briansune/LM25119_30A_EVB/thermal/IMG_20240531_173420.jpg

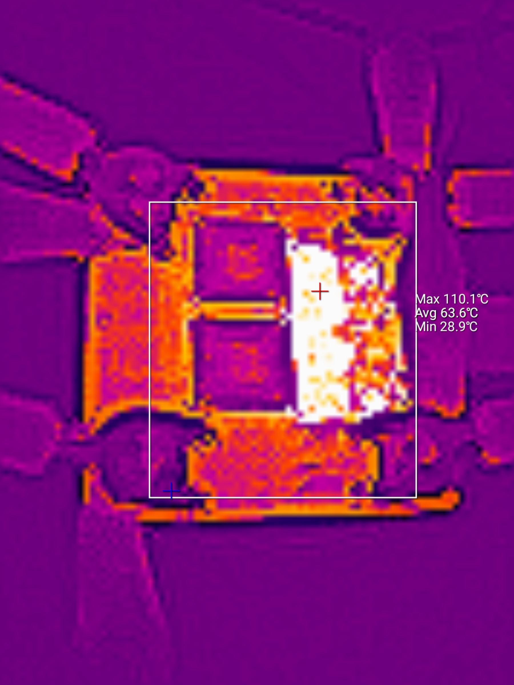
thermal/IMG_20240531_173420.jpg
