briansune/LM25119_30A_EVB/thermal/232khz.jpg

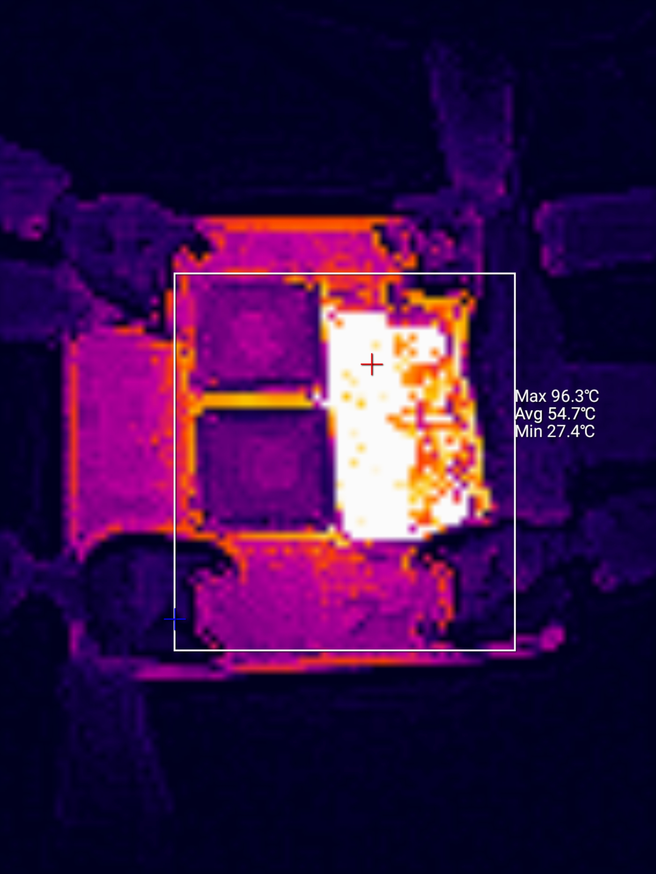
thermal/232khz.jpg
