briansune/LM25119_30A_EVB/thermal_150khz/150khz.jpg

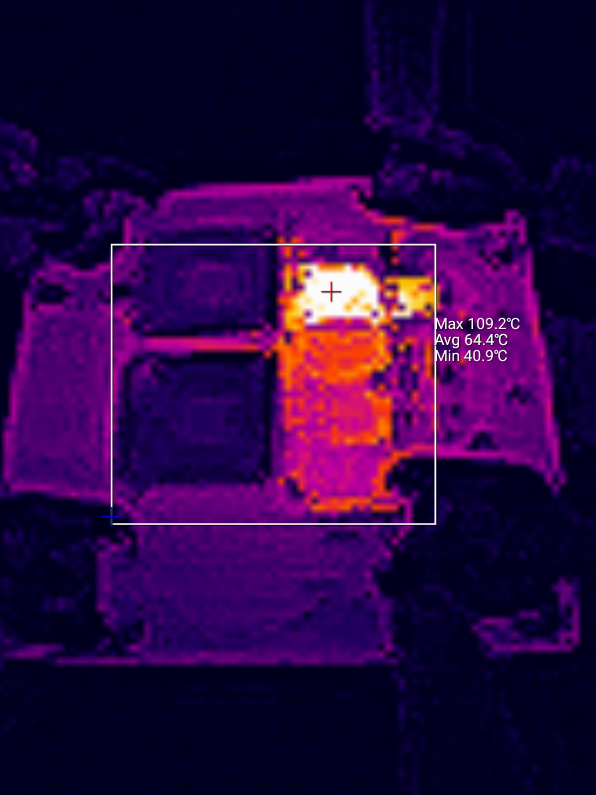
thermal_150khz/150khz.jpg
