briansune/LM25119_30A_EVB/thermal_150khz/IMG_20240606_025009.jpg

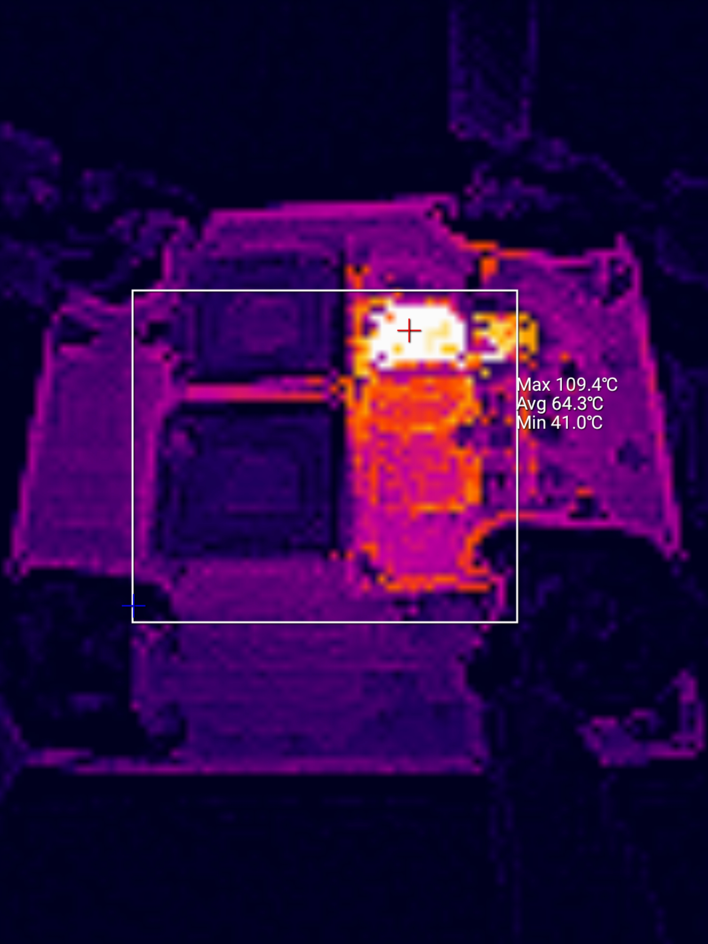
thermal_150khz/IMG_20240606_025009.jpg
