briansune/LM25119_30A_EVB/LM(2)5119 QuickStart ICC Modified.xlsx

Sheet: LM(2)5119 Calculator
LM(2)5119 Wide VIN Range Dual Synchronous Buck Controller
Note: The components calculated here are reasonable starting values for a design using the LM(2)5119 wide VIN controller. As such, components are not optimized for any particular performance attribute. Only one channel is shown. Calculate each channel separately for dual-output designs. Each channel is identical for interleaved designs.
Enter design parameters |  | Version 1.5 1/27/2014
in the shaded cells
Step 1: General Requirements | VIN (min) [V] | 24
 | VIN (max) [V] | 34
 | VOUT [V] | 3.31
 | Max Load Current per Channel [A] | 18 | 36
 | Ripple Current as % of Max Load Current | 22%
 | Minimum Duty Cycle | 0.10
 | Maximum Duty Cycle | 0.14
Step 2: Interleaved or Dual O/P | Interleaved / Dual Output Operation | Interleaved
 | IC Package | WQFN-32
 | Recommended IC | LM25119
Step 3: Switching Frequency | FSW [kHz] | 232
Step 4: Frequency Programming | Recommneded RT [kΩ] | 21.5
Step 5: Filter Inductance | Recommended LF per channel [µH] | 3.3
 | Enter LF [µH] | 3.3
 | Max Inductor Ripple Current [A] | 3.9
Step 6: Current Limit | Target (% beyond Max Load) | 20%
 | Output Current at Current Limit Inception [A] | 21.6
 | Slope Compensation Factor (K) | 2.4
 | Recommended RS [mΩ] per Channel | 4.0
 | Enter Closest Standard Value for RS [mΩ] | 4
 | Peak Output Current with Output Short [A] | 31.0
Step 7: Ramp Configuration | RRAMP [kΩ] | 82
 | Recommneded CRAMP [pF] | 419.2073171
Step 8: Output Capacitors | COUT1 per channel [µF] | 495
 | COUT2 per channel [µF]
 | Net Output Cap ESR per channel [mΩ] | 6 | 3
 | COUT1 + COUT2 [µF] | 495 | 990
 | Peak-peak VOUT Ripple [mV] | 23.8
Step 9: Input Capacitors | Input Capacitor CIN [µF] | 44
 | Input Voltage Ripple [V)] | 0.44
Step 10: VIN UV Shutdown | UV Shutdown Voltage [V] | 6.91
 | UV Hysteresis, VHYS [V] | 1.36
 | Upper UVLO Resistor RUV2 [kΩ] | 68.0
 | Lower UVLO Resistor RUV1 [kΩ] | 15.02
Step 11: Feedback Resistors | Lower FB Resistor RFB1 [kΩ] | 0.976
 | Upper FB Resistor RFB2 [kΩ] | 3.06
Step 12: Compensation Network | Loop Bandwidth [kHz] | 23
 | Recommended RCOMP [kΩ] | 13.3
 | RCOMP [kΩ] | 12
 | Recommneded CCOMP [nF] | 5.3
 | CCOMP [nF] | 5.6
 | Recommended Max CHF [pF] | 258.9444185
 | Recommended Min CHF [pF] | 24.85987175
 | CHF [pF] | 1
Step 13: Soft-Start Capacitor | Soft-Start Time [ms] | 0.1
 | Soft-Start Capacitor CSS [nF] | 1.25
Step 14: MOSFET Gate Charge | High-side MOSFET Qg @ VVCC [nC] | 28
 | Low-side MOSFET Qg @ VVCC [nC] | 28
 | MOSFET Total Gate Charge [nC] | 56
Step 15: Boot & VCC Capacitors | Minimum CVCC [µF] | 0.37
 | Minimum CHB [µF] | 0.19
 | VCC Run Current IVCC [mA] | 16.892
Step 16: Restart Capacitor | Restart Time [ms] | 59
 | Restart Capacitor CRES [µF] | 0.47

Sheet: Power Dissipation
LM(2)5119 Power Dissipation Calculations
Enter design parameters in the shaded cells
 |  | Common Assumptions |  |  |  |  |  | Channel 2 Requirements
 | Ambient Temperature TA | 35°C |  |  |  |  | High-side MOSFET Qg @ VVCC (nC) | 28
 | Package thermal Resisitance RJA | 40°C/W |  |  |  |  | Low-side MOSFET Qg @ VVCC (nC) | 28
 | External VCC Select "Yes" or "No" | No |  |  |  |  | Channel 2 Total Gate Charge (nC) | 56
 |  | 10 |  |  |  |  | Channel 2 VCC Run Current ICC (mA) | 12.992
Channel 1 Thermal Calculations
VIN | 24.0V | 25.0V | 26.0V | 22.1V | 28.0V | 29.0V | 30.0V | 31.0V | 32.0V | 33.0V | 34.0V
IC Power | 0.549W | 0.572W | 0.595W | 0.506W | 0.641W | 0.664W | 0.687W | 0.710W | 0.733W | 0.755W | 0.778W
DTJ above TA | 21.97632°C | 22.892°C | 23.80768°C | 20.236528°C | 25.63904°C | 26.55472°C | 27.4704°C | 28.38608°C | 29.30176°C | 30.21744°C | 31.13312°C
Junction Temperature | 56.97632°C | 57.892°C | 58.80768°C | 55.236528°C | 60.63904°C | 61.55472°C | 62.4704°C | 63.38608°C | 64.30176°C | 65.21744°C | 66.13312°C
Channel 2 Thermal Calculations
VIN | 24.0V | 25.0V | 26.0V | 22.1V | 28.0V | 29.0V | 30.0V | 31.0V | 32.0V | 33.0V | 34.0V
IC Power | 0.345W | 0.360W | 0.374W | 0.318W | 0.403W | 0.417W | 0.432W | 0.446W | 0.461W | 0.475W | 0.489W
DTJ above TA | 13.81632°C | 14.392°C | 14.96768°C | 12.722528°C | 16.11904°C | 16.69472°C | 17.2704°C | 17.84608°C | 18.42176°C | 18.99744°C | 19.57312°C
Junction Temperature | 48.81632°C | 49.392°C | 49.96768°C | 47.722528°C | 51.11904°C | 51.69472°C | 52.2704°C | 52.84608°C | 53.42176°C | 53.99744°C | 54.57312°C
Channel 1 + Channel 2 Thermal Calculations
VIN | 24.0V | 25.0V | 26.0V | 22.1V | 28.0V | 29.0V | 30.0V | 31.0V | 32.0V | 33.0V | 34.0V
Total IC Power | 0.895W | 0.932W | 0.969W | 0.824W | 1.044W | 1.081W | 1.119W | 1.156W | 1.193W | 1.230W | 1.268W
DTJ above TA | 35.79264°C | 37.284°C | 38.77536°C | 32.959056°C | 41.75808°C | 43.24944°C | 44.7408°C | 46.23216°C | 47.72352°C | 49.21488°C | 50.70624°C
Junction Temperature | 70.79264°C | 72.284°C | 73.77536°C | 67.959056°C | 76.75808°C | 78.24944°C | 79.7408°C | 81.23216°C | 82.72352°C | 84.21488°C | 85.70624°C

Sheet: Bode Plots
LM(2)5119 Bode Plot Calculations
Frequency (Hz) | Frequency (rad/sec) | Modulator Gain (dB) | Modulator Phase (°) | Error Amplifier Gain (dB) | Error Amplifier Phase (°) | Loop Gain (dB) | Loop Phase (°) | Frequency Compensation Parameters
1 | 6.283185307 | 10.0 | -0.02487870666 | 67.37213114 | 165.2225541 | 77.4 | 165.2 | Modulator
2 | 12.56637061 | 10.0 | -0.0497574059 | 66.59557892 | 152.1925431 | 76.6 | 152.1 | ωp_lf | 15652.42678 | rad/s | 2491.161093 | Hz
5 | 31.41592654 | 10.0 | -0.1 | 63.27902162 | 127.2413816 | 73.3 | 127.1 | ωp_hf | 122105.2632 | rad/s | 19.4 | kHz
10 | 62.83185307 | 10.0 | -0.2 | 58.64416824 | 110.9677735 | 68.6 | 110.7 | ωz_esr | 336700.3367 | rad/s | 53.6 | kHz | Additional Definitions
20 | 125.6637061 | 10.0 | -0.5 | 53.05233031 | 101.1923611 | 63.0 | 100.7 | ωp_esr | 100000000000 | rad/s | 15915494.31 | kHz
50 | 314.1592654 | 10.0 | -1.2 | 45.22313022 | 95.52146884 | 55.2 | 94.3 | ωn | 728849.4956 | rad/s | 116 | kHz | RLOAD | 0.1838888889 | Ω
100 | 628.3185307 | 10.0 | -2.5 | 39.22692357 | 94.55226057 | 49.2 | 92.1 |  |  |  |  |  | DC GAIN MOD | 0.005 | V/V
200 | 1256.637061 | 10.0 | -5.0 | 33.23410489 | 95.84534419 | 43.2 | 90.9 | Am | 3.2 | V/V | 10.0 | dB | VCC | 7.6 | V
400 | 2513.274123 | 9.9 | -9.9 | 27.30594019 | 99.99710187 | 37.2 | 90.1
600 | 3769.911184 | 9.7 | -14.7 | 23.9323076 | 104.380536 | 33.7 | 89.7
800 | 5026.548246 | 9.6 | -19.3 | 21.63265121 | 108.6725798 | 31.2 | 89.4
1000 | 6283.185307 | 9.3 | -23.7 | 19.93767901 | 112.7795052 | 29.3 | 89.0 | Error Amplifier
1200 | 7539.822369 | 9.1 | -28.0 | 18.63391943 | 116.6570249 | 27.7 | 88.7 | ωzero | 14880.95238 | rad/s | 2368.377129 | Hz
1500 | 9424.777961 | 8.6 | -33.9 | 17.16800386 | 122.0000945 | 25.8 | 88.1 | ωpole | 58304.33888 | rad/s | 9.3 | kHz
2000 | 12566.37061 | 7.8 | -42.5 | 15.54208004 | 129.6316731 | 23.3 | 87.1 | ωhf | 83348214.29 | rad/s | 13265.3 | kHz
3000 | 18849.55592 | 6.0 | -55.9 | 13.83894238 | 140.7979323 | 19.8 | 84.9 | ωbw | 18849555.92 | rad/s | 3 | MHz
4000 | 25132.74123 | 4.3 | -65.5 | 13.03929624 | 148.1118435 | 17.3 | 82.7
5000 | 31415.92654 | 2.7 | -72.6 | 12.61194946 | 153.0567225 | 15.4 | 80.4
6000 | 37699.11184 | 1.3 | -78.3 | 12.36013458 | 156.5267067 | 13.7 | 78.3 | AOL | 10000 | V/V | 80 | dB
7000 | 43982.29715 | 0.1 | -82.8 | 12.2001156 | 159.0416324 | 12.3 | 76.2 | ωol | 1884.955592 | rad/s | 300 | Hz
8000 | 50265.48246 | -1.1 | -86.7 | 12.09215388 | 160.9115758 | 11.0 | 74.2 | AEA | -1.57 | V/V |  |  |  | q
9000 | 56548.66776 | -2.2 | -90.0 | 12.01566328 | 162.3290103 | 9.8 | 72.4 | ZEA | 9279.424563 | Ω |  |  |  | 0.167531519
10000 | 62831.85307 | -3.2 | -92.8 | 11.95919427 | 163.4183121 | 8.8 | 70.6 | ωo | 58304.33888 | rad/s | 9.3 | kHz |  | Fcross Max (kHz)
12000 | 75398.22369 | -5.0 | -97.6 | 11.88189678 | 164.9203803 | 6.9 | 67.3 |  |  |  |  |  |  | 18.91684046
15000 | 94247.77961 | -7.3 | -103.1 | 11.81141944 | 166.1300517 | 4.5 | 63.1 | Zea | 3.967 | Ω |  |  |  | Correction Factor
20000 | 125663.7061 | -10.6 | -109.1 | 11.74029902 | 166.7205274 | 1.1 | 57.6 | KFB | 0.242 | V/V | -12.3 | dB |  | 1.52
30000 | 188495.5592 | -15.6 | -114.9 | 11.63711617 | 165.7404386 | -4.0 | 50.9
40000 | 251327.4123 | -19.2 | -116.5 | 11.52960976 | 163.7087027 | -7.7 | 47.2
60000 | 376991.1184 | -24.2 | -116.0 | 11.25876319 | 158.7707224 | -12.9 | 42.7
100000 | 628318.5307 | -29.8 | -113.9 | 10.50764358 | 148.8295696 | -19.3 | 34.9
200000 | 1256637.061 | -36.8 | -115.1 | 8.098957948 | 130.4058521 | -28.7 | 15.3
350000 | 2199114.858 | -42.5 | -122.5 | 4.733870447 | 116.0483491 | -37.7 | -6.5
600000 | 3769911.184 | -48.7 | -134.7 | 0.6646070699 | 105.8568764 | -48.1 | -28.8
1000000 | 6283185.307 | -55.7 | -147.9 | -3.549684547 | 99.5246886 | -59.2 | -48.3
