briansune/LM25119_30A_EVB/LM(2)5119 QuickStart ICC Modified_2u2H.xlsx

Sheet: LM(2)5119 Calculator
LM(2)5119 Wide VIN Range Dual Synchronous Buck Controller
Note: The components calculated here are reasonable starting values for a design using the LM(2)5119 wide VIN controller. As such, components are not optimized for any particular performance attribute. Only one channel is shown. Calculate each channel separately for dual-output designs. Each channel is identical for interleaved designs.
Enter design parameters |  | Version 1.5 1/27/2014
in the shaded cells
Step 1: General Requirements | VIN (min) [V] | 24
 | VIN (max) [V] | 34
 | VOUT [V] | 3.31
 | Max Load Current per Channel [A] | 18 | 36
 | Ripple Current as % of Max Load Current | 40%
 | Minimum Duty Cycle | 0.10
 | Maximum Duty Cycle | 0.14
Step 2: Interleaved or Dual O/P | Interleaved / Dual Output Operation | Interleaved
 | IC Package | WQFN-32
 | Recommended IC | LM25119
Step 3: Switching Frequency | FSW [kHz] | 126
Step 4: Frequency Programming | Recommneded RT [kΩ] | 40.3
Step 5: Filter Inductance | Recommended LF per channel [µH] | 3.3
 | Enter LF [µH] | 3.3
 | Max Inductor Ripple Current [A] | 7.2
Step 6: Current Limit | Target (% beyond Max Load) | 20%
 | Output Current at Current Limit Inception [A] | 21.6
 | Slope Compensation Factor (K) | 1.5
 | Recommended RS [mΩ] per Channel | 4.0
 | Enter Closest Standard Value for RS [mΩ] | 4
 | Peak Output Current with Output Short [A] | 31.0
Step 7: Ramp Configuration | RRAMP [kΩ] | 82
 | Recommneded CRAMP [pF] | 670.7317073
Step 8: Output Capacitors | COUT1 per channel [µF] | 300
 | COUT2 per channel [µF]
 | Net Output Cap ESR per channel [mΩ] | 8.333333333 | 4.166666667
 | COUT1 + COUT2 [µF] | 300 | 600
 | Peak-peak VOUT Ripple [mV] | 64.4
Step 9: Input Capacitors | Input Capacitor CIN [µF] | 44
 | Input Voltage Ripple [V)] | 0.81
Step 10: VIN UV Shutdown | UV Shutdown Voltage [V] | 6.91
 | UV Hysteresis, VHYS [V] | 1.36
 | Upper UVLO Resistor RUV2 [kΩ] | 68.0
 | Lower UVLO Resistor RUV1 [kΩ] | 15.02
Step 11: Feedback Resistors | Lower FB Resistor RFB1 [kΩ] | 0.976
 | Upper FB Resistor RFB2 [kΩ] | 3.06
Step 12: Compensation Network | Loop Bandwidth [kHz] | 23
 | Recommended RCOMP [kΩ] | 7.6
 | RCOMP [kΩ] | 6.2
 | Recommneded CCOMP [nF] | 6.4
 | CCOMP [nF] | 6.8
 | Recommended Max CHF [pF] | 428.6434695
 | Recommended Min CHF [pF] | 40.56311143
 | CHF [pF] | 1
Step 13: Soft-Start Capacitor | Soft-Start Time [ms] | 0.1
 | Soft-Start Capacitor CSS [nF] | 1.25
Step 14: MOSFET Gate Charge | High-side MOSFET Qg @ VVCC [nC] | 28
 | Low-side MOSFET Qg @ VVCC [nC] | 28
 | MOSFET Total Gate Charge [nC] | 56
Step 15: Boot & VCC Capacitors | Minimum CVCC [µF] | 0.37
 | Minimum CHB [µF] | 0.19
 | VCC Run Current IVCC [mA] | 10.956
Step 16: Restart Capacitor | Restart Time [ms] | 59
 | Restart Capacitor CRES [µF] | 0.47

Sheet: Power Dissipation
LM(2)5119 Power Dissipation Calculations
Enter design parameters in the shaded cells
 |  | Common Assumptions |  |  |  |  |  | Channel 2 Requirements
 | Ambient Temperature TA | 35°C |  |  |  |  | High-side MOSFET Qg @ VVCC (nC) | 28
 | Package thermal Resisitance RJA | 40°C/W |  |  |  |  | Low-side MOSFET Qg @ VVCC (nC) | 28
 | External VCC Select "Yes" or "No" | No |  |  |  |  | Channel 2 Total Gate Charge (nC) | 56
 |  | 10 |  |  |  |  | Channel 2 VCC Run Current ICC (mA) | 7.056
Channel 1 Thermal Calculations
VIN | 24.0V | 25.0V | 26.0V | 22.1V | 28.0V | 29.0V | 30.0V | 31.0V | 32.0V | 33.0V | 34.0V
IC Power | 0.407W | 0.424W | 0.441W | 0.375W | 0.475W | 0.492W | 0.509W | 0.526W | 0.543W | 0.560W | 0.577W
DTJ above TA | 16.27776°C | 16.956°C | 17.63424°C | 14.989104°C | 18.99072°C | 19.66896°C | 20.3472°C | 21.02544°C | 21.70368°C | 22.38192°C | 23.06016°C
Junction Temperature | 51.27776°C | 51.956°C | 52.63424°C | 49.989104°C | 53.99072°C | 54.66896°C | 55.3472°C | 56.02544°C | 56.70368°C | 57.38192°C | 58.06016°C
Channel 2 Thermal Calculations
VIN | 24.0V | 25.0V | 26.0V | 22.1V | 28.0V | 29.0V | 30.0V | 31.0V | 32.0V | 33.0V | 34.0V
IC Power | 0.203W | 0.211W | 0.220W | 0.187W | 0.237W | 0.245W | 0.254W | 0.262W | 0.271W | 0.279W | 0.288W
DTJ above TA | 8.11776°C | 8.456°C | 8.79424°C | 7.475104°C | 9.47072°C | 9.80896°C | 10.1472°C | 10.48544°C | 10.82368°C | 11.16192°C | 11.50016°C
Junction Temperature | 43.11776°C | 43.456°C | 43.79424°C | 42.475104°C | 44.47072°C | 44.80896°C | 45.1472°C | 45.48544°C | 45.82368°C | 46.16192°C | 46.50016°C
Channel 1 + Channel 2 Thermal Calculations
VIN | 24.0V | 25.0V | 26.0V | 22.1V | 28.0V | 29.0V | 30.0V | 31.0V | 32.0V | 33.0V | 34.0V
Total IC Power | 0.610W | 0.635W | 0.661W | 0.562W | 0.712W | 0.737W | 0.762W | 0.788W | 0.813W | 0.839W | 0.864W
DTJ above TA | 24.39552°C | 25.412°C | 26.42848°C | 22.464208°C | 28.46144°C | 29.47792°C | 30.4944°C | 31.51088°C | 32.52736°C | 33.54384°C | 34.56032°C
Junction Temperature | 59.39552°C | 60.412°C | 61.42848°C | 57.464208°C | 63.46144°C | 64.47792°C | 65.4944°C | 66.51088°C | 67.52736°C | 68.54384°C | 69.56032°C

Sheet: Bode Plots
LM(2)5119 Bode Plot Calculations
Frequency (Hz) | Frequency (rad/sec) | Modulator Gain (dB) | Modulator Phase (°) | Error Amplifier Gain (dB) | Error Amplifier Phase (°) | Loop Gain (dB) | Loop Phase (°) | Frequency Compensation Parameters
1 | 6.283185307 | 10.1 | -0.01615400885 | 67.24212647 | 162.2760655 | 77.3 | 162.3 | Modulator
2 | 12.56637061 | 10.1 | -0.03230801595 | 66.17515297 | 147.4197305 | 76.2 | 147.4 | ωp_lf | 25357.71515 | rad/s | 4035.805711 | Hz
5 | 31.41592654 | 10.1 | -0.1 | 62.15290281 | 122.0892623 | 72.2 | 122.0 | ωp_hf | 126000 | rad/s | 20.1 | kHz
10 | 62.83185307 | 10.1 | -0.2 | 57.16033797 | 107.5096379 | 67.2 | 107.3 | ωz_esr | 400000 | rad/s | 63.7 | kHz | Additional Definitions
20 | 125.6637061 | 10.1 | -0.3 | 51.43993301 | 99.18363983 | 61.5 | 98.9 | ωp_esr | 100000000000 | rad/s | 15915494.31 | kHz
50 | 314.1592654 | 10.1 | -0.8 | 43.56965619 | 94.32743905 | 53.6 | 93.5 | ωn | 395840.6744 | rad/s | 63 | kHz | RLOAD | 0.1838888889 | Ω
100 | 628.3185307 | 10.1 | -1.6 | 37.56404182 | 93.29000883 | 47.6 | 91.7 |  |  |  |  |  | DC GAIN MOD | 0.005 | V/V
200 | 1256.637061 | 10.1 | -3.2 | 31.55574828 | 93.89231868 | 41.6 | 90.7 | Am | 3.2 | V/V | 10.1 | dB | VCC | 7.6 | V
400 | 2513.274123 | 10.0 | -6.4 | 25.57225444 | 96.4245425 | 35.6 | 90.0
600 | 3769.911184 | 10.0 | -9.6 | 22.11042721 | 99.22198917 | 32.1 | 89.6
800 | 5026.548246 | 9.9 | -12.8 | 19.69413257 | 102.0455535 | 29.6 | 89.3
1000 | 6283.185307 | 9.8 | -15.9 | 17.85968691 | 104.8366926 | 27.7 | 89.0 | Error Amplifier
1200 | 7539.822369 | 9.7 | -18.9 | 16.39958097 | 107.5685311 | 26.1 | 88.7 | ωzero | 23719.16509 | rad/s | 3775.022369 | Hz
1500 | 9424.777961 | 9.5 | -23.3 | 14.6799562 | 111.5208758 | 24.2 | 88.2 | ωpole | 48016.85076 | rad/s | 7.6 | kHz
2000 | 12566.37061 | 9.1 | -30.3 | 12.61888474 | 117.6456353 | 21.7 | 87.4 | ωhf | 161314041.7 | rad/s | 25673.9 | kHz
3000 | 18849.55592 | 8.1 | -42.5 | 10.14841377 | 127.9960599 | 18.2 | 85.5 | ωbw | 18849555.92 | rad/s | 3 | MHz
4000 | 25132.74123 | 7.0 | -52.5 | 8.792334296 | 135.9852873 | 15.8 | 83.5
5000 | 31415.92654 | 5.8 | -60.7 | 7.984870225 | 142.0867111 | 13.8 | 81.4
6000 | 37699.11184 | 4.7 | -67.5 | 7.473724471 | 146.7776307 | 12.2 | 79.3 | AOL | 10000 | V/V | 80 | dB
7000 | 43982.29715 | 3.7 | -73.2 | 7.13346866 | 150.4335917 | 10.8 | 77.2 | ωol | 1884.955592 | rad/s | 300 | Hz
8000 | 50265.48246 | 2.7 | -78.1 | 6.897222108 | 153.3271571 | 9.6 | 75.2 | AEA | -1.57 | V/V |  |  |  | q
9000 | 56548.66776 | 1.7 | -82.4 | 6.727250161 | 155.6516731 | 8.5 | 73.2 | ZEA | 7642.119419 | Ω |  |  |  | 0.3183098862
10000 | 62831.85307 | 0.9 | -86.2 | 6.601201937 | 157.5444271 | 7.5 | 71.4 | ωo | 48016.85076 | rad/s | 7.6 | kHz |  | Fcross Max (kHz)
12000 | 75398.22369 | -0.8 | -92.6 | 6.430580826 | 160.4022092 | 5.6 | 67.8 |  |  |  |  |  |  | 18.35187243
15000 | 94247.77961 | -3.0 | -100.1 | 6.284027994 | 163.1990913 | 3.3 | 63.1 | Zea | 2.088 | Ω |  |  |  | Correction Factor
20000 | 125663.7061 | -6.2 | -109.1 | 6.161956923 | 165.7398509 | 0.003888323343 | 56.6 | KFB | 0.242 | V/V | -12.3 | dB |  | 1.44
30000 | 188495.5592 | -11.1 | -119.8 | 6.057089366 | 167.4722516 | -5.0 | 47.7
40000 | 251327.4123 | -14.8 | -125.4 | 5.998054478 | 167.4803268 | -8.8 | 42.0
60000 | 376991.1184 | -20.2 | -131.1 | 5.894014057 | 165.7714753 | -14.3 | 34.7
100000 | 628318.5307 | -26.8 | -137.1 | 5.628546627 | 160.4661043 | -21.1 | 23.3
200000 | 1256637.061 | -36.1 | -148.8 | 4.596856283 | 146.8730637 | -31.5 | -1.9
350000 | 2199114.858 | -44.5 | -159.3 | 2.611544749 | 131.7430082 | -41.9 | -27.6
600000 | 3769911.184 | -53.4 | -167.2 | -0.5186188702 | 117.5765757 | -53.9 | -49.7
1000000 | 6283185.307 | -62.0 | -172.2 | -4.291730772 | 107.2970142 | -66.3 | -64.9
