briansune/LM25119_30A_EVB/LM(2)5119 QuickStart ICC Modified_3u3H.xlsx

Sheet: LM(2)5119 Calculator
LM(2)5119 Wide VIN Range Dual Synchronous Buck Controller
Note: The components calculated here are reasonable starting values for a design using the LM(2)5119 wide VIN controller. As such, components are not optimized for any particular performance attribute. Only one channel is shown. Calculate each channel separately for dual-output designs. Each channel is identical for interleaved designs.
Enter design parameters |  | Version 1.5 1/27/2014
in the shaded cells
Step 1: General Requirements | VIN (min) [V] | 24
 | VIN (max) [V] | 34
 | VOUT [V] | 3.31
 | Max Load Current per Channel [A] | 18 | 36
 | Ripple Current as % of Max Load Current | 33%
 | Minimum Duty Cycle | 0.10
 | Maximum Duty Cycle | 0.14
Step 2: Interleaved or Dual O/P | Interleaved / Dual Output Operation | Interleaved
 | IC Package | WQFN-32
 | Recommended IC | LM25119
Step 3: Switching Frequency | FSW [kHz] | 152.5
Step 4: Frequency Programming | Recommneded RT [kΩ] | 33.2
Step 5: Filter Inductance | Recommended LF per channel [µH] | 3.3
 | Enter LF [µH] | 3.3
 | Max Inductor Ripple Current [A] | 5.9
Step 6: Current Limit | Target (% beyond Max Load) | 20%
 | Output Current at Current Limit Inception [A] | 21.6
 | Slope Compensation Factor (K) | 1.7
 | Recommended RS [mΩ] per Channel | 4.0
 | Enter Closest Standard Value for RS [mΩ] | 4
 | Peak Output Current with Output Short [A] | 31.0
Step 7: Ramp Configuration | RRAMP [kΩ] | 75
 | Recommneded CRAMP [pF] | 647.0588235
Step 8: Output Capacitors | COUT1 per channel [µF] | 660
 | COUT2 per channel [µF]
 | Net Output Cap ESR per channel [mΩ] | 4.5 | 2.25
 | COUT1 + COUT2 [µF] | 660 | 1320
 | Peak-peak VOUT Ripple [mV] | 27.7
Step 9: Input Capacitors | Input Capacitor CIN [µF] | 188
 | Input Voltage Ripple [V)] | 0.16
Step 10: VIN UV Shutdown | UV Shutdown Voltage [V] | 15.35
 | UV Hysteresis, VHYS [V] | 2
 | Upper UVLO Resistor RUV2 [kΩ] | 100.0
 | Lower UVLO Resistor RUV1 [kΩ] | 8.87
Step 11: Feedback Resistors | Lower FB Resistor RFB1 [kΩ] | 0.976
 | Upper FB Resistor RFB2 [kΩ] | 3.06
Step 12: Compensation Network | Loop Bandwidth [kHz] | 14.9
 | Recommended RCOMP [kΩ] | 9.2
 | RCOMP [kΩ] | 10
 | Recommneded CCOMP [nF] | 8.6
 | CCOMP [nF] | 8.2
 | Recommended Max CHF [pF] | 308.1614577
 | Recommended Min CHF [pF] | 29.80796299
 | CHF [pF] | 1
Step 13: Soft-Start Capacitor | Soft-Start Time [ms] | 0.8
 | Soft-Start Capacitor CSS [nF] | 10
Step 14: MOSFET Gate Charge | High-side MOSFET Qg @ VVCC [nC] | 28
 | Low-side MOSFET Qg @ VVCC [nC] | 28
 | MOSFET Total Gate Charge [nC] | 56
Step 15: Boot & VCC Capacitors | Minimum CVCC [µF] | 0.37
 | Minimum CHB [µF] | 0.19
 | VCC Run Current IVCC [mA] | 12.44
Step 16: Restart Capacitor | Restart Time [ms] | 59
 | Restart Capacitor CRES [µF] | 0.47

Sheet: Power Dissipation
LM(2)5119 Power Dissipation Calculations
Enter design parameters in the shaded cells
 |  | Common Assumptions |  |  |  |  |  | Channel 2 Requirements
 | Ambient Temperature TA | 35°C |  |  |  |  | High-side MOSFET Qg @ VVCC (nC) | 28
 | Package thermal Resisitance RJA | 40°C/W |  |  |  |  | Low-side MOSFET Qg @ VVCC (nC) | 28
 | External VCC Select "Yes" or "No" | No |  |  |  |  | Channel 2 Total Gate Charge (nC) | 56
 |  | 10 |  |  |  |  | Channel 2 VCC Run Current ICC (mA) | 8.54
Channel 1 Thermal Calculations
VIN | 24.0V | 25.0V | 26.0V | 22.1V | 28.0V | 29.0V | 30.0V | 31.0V | 32.0V | 33.0V | 34.0V
IC Power | 0.443W | 0.461W | 0.479W | 0.408W | 0.516W | 0.535W | 0.553W | 0.572W | 0.590W | 0.609W | 0.627W
DTJ above TA | 17.7024°C | 18.44°C | 19.1776°C | 16.30096°C | 20.6528°C | 21.3904°C | 22.128°C | 22.8656°C | 23.6032°C | 24.3408°C | 25.0784°C
Junction Temperature | 52.7024°C | 53.44°C | 54.1776°C | 51.30096°C | 55.6528°C | 56.3904°C | 57.128°C | 57.8656°C | 58.6032°C | 59.3408°C | 60.0784°C
Channel 2 Thermal Calculations
VIN | 24.0V | 25.0V | 26.0V | 22.1V | 28.0V | 29.0V | 30.0V | 31.0V | 32.0V | 33.0V | 34.0V
IC Power | 0.239W | 0.249W | 0.258W | 0.220W | 0.278W | 0.288W | 0.298W | 0.308W | 0.318W | 0.328W | 0.338W
DTJ above TA | 9.5424°C | 9.94°C | 10.3376°C | 8.78696°C | 11.1328°C | 11.5304°C | 11.928°C | 12.3256°C | 12.7232°C | 13.1208°C | 13.5184°C
Junction Temperature | 44.5424°C | 44.94°C | 45.3376°C | 43.78696°C | 46.1328°C | 46.5304°C | 46.928°C | 47.3256°C | 47.7232°C | 48.1208°C | 48.5184°C
Channel 1 + Channel 2 Thermal Calculations
VIN | 24.0V | 25.0V | 26.0V | 22.1V | 28.0V | 29.0V | 30.0V | 31.0V | 32.0V | 33.0V | 34.0V
Total IC Power | 0.681W | 0.710W | 0.738W | 0.627W | 0.795W | 0.823W | 0.851W | 0.880W | 0.908W | 0.937W | 0.965W
DTJ above TA | 27.2448°C | 28.38°C | 29.5152°C | 25.08792°C | 31.7856°C | 32.9208°C | 34.056°C | 35.1912°C | 36.3264°C | 37.4616°C | 38.5968°C
Junction Temperature | 62.2448°C | 63.38°C | 64.5152°C | 60.08792°C | 66.7856°C | 67.9208°C | 69.056°C | 70.1912°C | 71.3264°C | 72.4616°C | 73.5968°C

Sheet: Bode Plots
LM(2)5119 Bode Plot Calculations
Frequency (Hz) | Frequency (rad/sec) | Modulator Gain (dB) | Modulator Phase (°) | Error Amplifier Gain (dB) | Error Amplifier Phase (°) | Loop Gain (dB) | Loop Phase (°) | Frequency Compensation Parameters
1 | 6.283185307 | 10.1 | -0.03265013504 | 67.0642484 | 158.9601593 | 77.2 | 158.9 | Modulator
2 | 12.56637061 | 10.1 | -0.1 | 65.64127608 | 142.4443719 | 75.7 | 142.4 | ωp_lf | 11655.55974 | rad/s | 1855.039947 | Hz
5 | 31.41592654 | 10.1 | -0.2 | 60.93468917 | 117.5821135 | 71.0 | 117.4 | ωp_hf | 127083.3333 | rad/s | 20.2 | kHz
10 | 62.83185307 | 10.1 | -0.3 | 55.66736276 | 104.8437167 | 65.8 | 104.5 | ωz_esr | 336700.3367 | rad/s | 53.6 | kHz | Additional Definitions
20 | 125.6637061 | 10.1 | -0.7 | 49.85774613 | 97.97970407 | 59.9 | 97.3 | ωp_esr | 100000000000 | rad/s | 15915494.31 | kHz
50 | 314.1592654 | 10.1 | -1.6 | 41.96222235 | 94.43359885 | 52.1 | 92.8 | ωn | 479092.8797 | rad/s | 76.25 | kHz | RLOAD | 0.1838888889 | Ω
100 | 628.3185307 | 10.1 | -3.3 | 35.95901753 | 94.40851304 | 46.0 | 91.1 |  |  |  |  |  | DC GAIN MOD | 0.005 | V/V
200 | 1256.637061 | 10.0 | -6.5 | 29.97496587 | 96.57123792 | 40.0 | 90.1 | Am | 3.2 | V/V | 10.1 | dB | VCC | 7.6 | V
400 | 2513.274123 | 9.9 | -12.9 | 24.08967745 | 101.9056134 | 34.0 | 89.0
600 | 3769.911184 | 9.7 | -19.0 | 20.78366127 | 107.2592292 | 30.4 | 88.3
800 | 5026.548246 | 9.3 | -24.7 | 18.56996954 | 112.3639223 | 27.9 | 87.6
1000 | 6283.185307 | 9.0 | -30.1 | 16.97275911 | 117.1293199 | 25.9 | 87.0 | Error Amplifier
1200 | 7539.822369 | 8.6 | -35.0 | 15.77251121 | 121.517542 | 24.3 | 86.5 | ωzero | 12195.12195 | rad/s | 1940.91394 | Hz
1500 | 9424.777961 | 7.9 | -41.6 | 14.4621435 | 127.3803123 | 22.4 | 85.8 | ωpole | 39819.85149 | rad/s | 6.3 | kHz
2000 | 12566.37061 | 6.7 | -50.7 | 13.07190505 | 135.3775706 | 19.8 | 84.7 | ωhf | 100012195.1 | rad/s | 15917.4 | kHz
3000 | 18849.55592 | 4.4 | -63.5 | 11.70789747 | 146.314256 | 16.2 | 82.8 | ωbw | 18849555.92 | rad/s | 3 | MHz
4000 | 25132.74123 | 2.5 | -72.1 | 11.10691184 | 153.0417791 | 13.6 | 81.0
5000 | 31415.92654 | 0.7 | -78.3 | 10.79732287 | 157.425213 | 11.5 | 79.2
6000 | 37699.11184 | -0.8 | -83.1 | 10.61885375 | 160.4322684 | 9.9 | 77.4 | AOL | 10000 | V/V | 80 | dB
7000 | 43982.29715 | -2.1 | -87.0 | 10.50698553 | 162.5794838 | 8.4 | 75.6 | ωol | 1884.955592 | rad/s | 300 | Hz
8000 | 50265.48246 | -3.3 | -90.3 | 10.43217494 | 164.1593088 | 7.1 | 73.9 | AEA | -1.57 | V/V |  |  |  | q
9000 | 56548.66776 | -4.4 | -93.1 | 10.37947751 | 165.3472395 | 6.0 | 72.2 | ZEA | 6337.527039 | Ω |  |  |  | 0.2652582385
10000 | 62831.85307 | -5.4 | -95.6 | 10.34071734 | 166.254098 | 5.0 | 70.6 | ωo | 39819.85149 | rad/s | 6.3 | kHz |  | Fcross Max (kHz)
12000 | 75398.22369 | -7.2 | -99.9 | 10.2877983 | 167.4938512 | 3.1 | 67.6 |  |  |  |  |  |  | 18.97358465
15000 | 94247.77961 | -9.5 | -105.0 | 10.23953099 | 168.4761017 | 0.8 | 63.5 | Zea | 3.292 | Ω |  |  |  | Correction Factor
20000 | 125663.7061 | -12.7 | -111.0 | 10.19041292 | 168.9239803 | -2.5 | 58.0 | KFB | 0.242 | V/V | -12.3 | dB |  | 1.21
30000 | 188495.5592 | -17.6 | -117.5 | 10.1176192 | 168.0244983 | -7.4 | 50.5
40000 | 251327.4123 | -21.1 | -120.5 | 10.04033982 | 166.2461885 | -11.1 | 45.8
60000 | 376991.1184 | -26.1 | -122.7 | 9.842412021 | 161.9232628 | -16.3 | 39.2
100000 | 628318.5307 | -32.0 | -125.4 | 9.275907393 | 153.0111018 | -22.7 | 27.6
200000 | 1256637.061 | -40.0 | -135.2 | 7.314315842 | 135.2929065 | -32.7 | 0.1
350000 | 2199114.858 | -47.5 | -147.6 | 4.305996178 | 120.1209702 | -43.2 | -27.5
600000 | 3769911.184 | -55.7 | -159.0 | 0.4344052332 | 108.6479642 | -55.3 | -50.3
1000000 | 6283185.307 | -64.1 | -166.8 | -3.69820681 | 101.3039274 | -67.8 | -65.5
