briansune/LM25119_30A_EVB/DEBUG/LM25119_DEBUG.docx

VIN=26V

VOUT=1.7894V

VRT = 1.2411V (no wave)

VRES = 0.0004V (no wave)

VCC2=7.439V

VCC1=7.511V

Cont’d Waveforms

CH1 SW

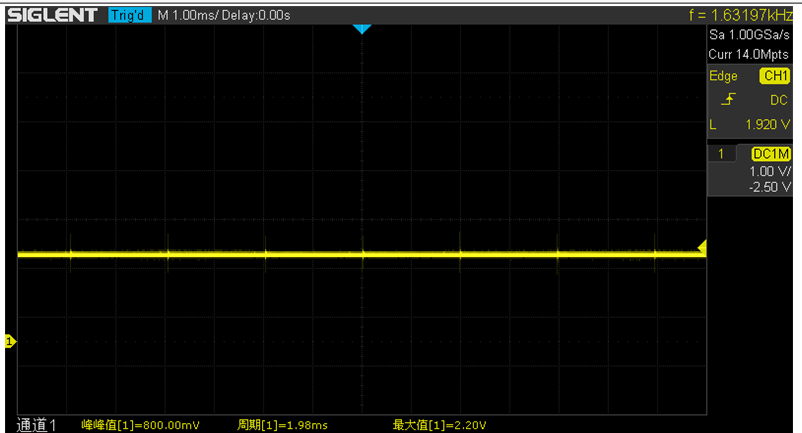
[picture p8: figure]

CH2 SW

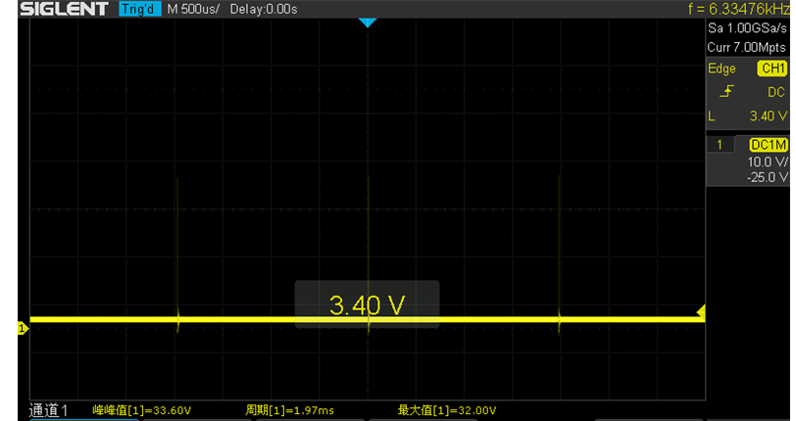
[picture p9: figure]

CH2+COMP1&2

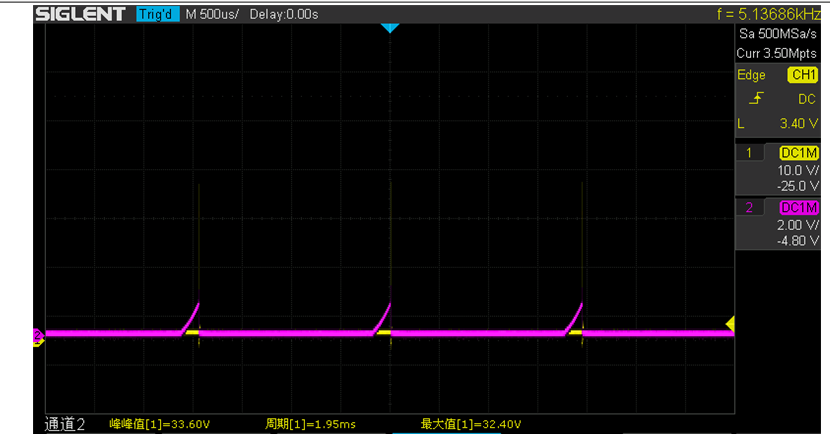
[picture p10: figure]

CH2 GATE H, GATE L

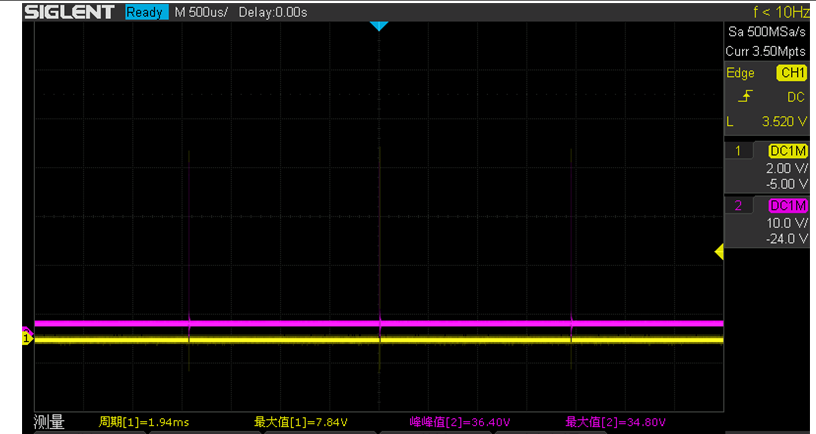
[picture p11: figure]

CH2 GATE H, GATE L

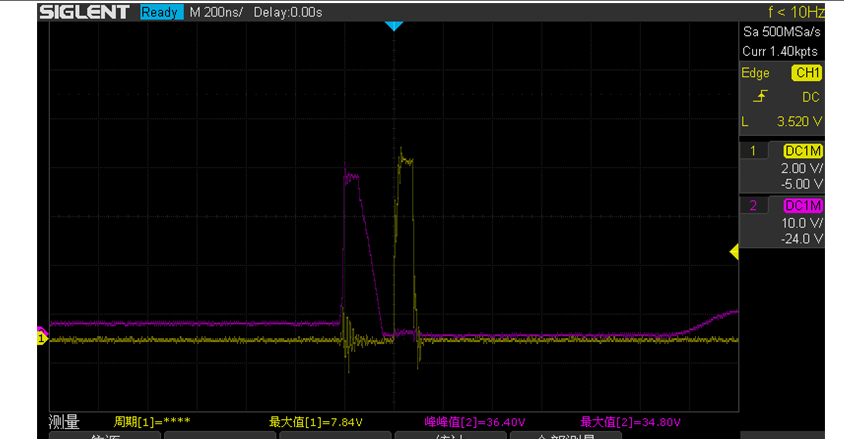
[picture p12: figure]
