briansune/LM25119_30A_EVB/DEBUG/LM25119_DEBUG3.docx

VIN=26V, VOUT=3.3V @ No LOAD

CH1 SW

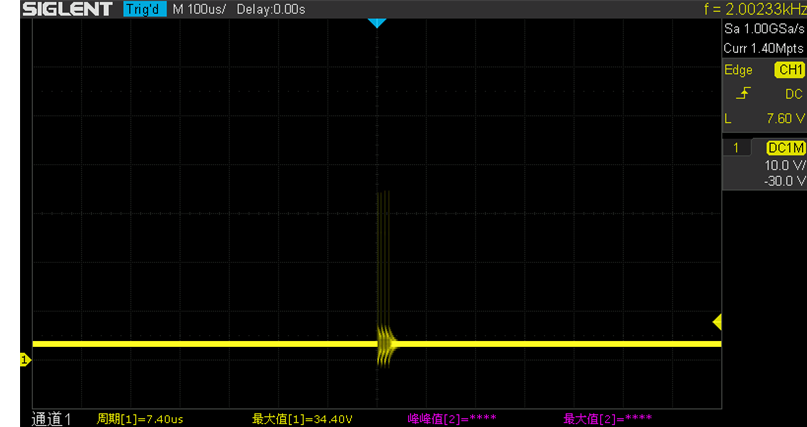
[picture p13: figure]
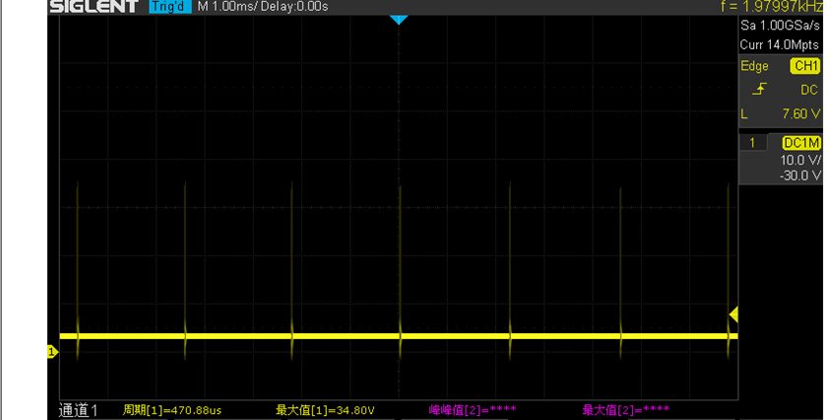
[picture p14: figure]

CH 1 GATE H

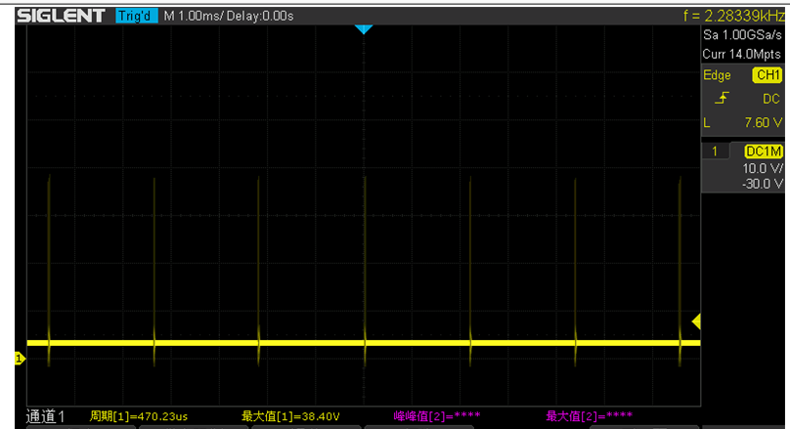
[picture p15: figure]

CH1 GATE L

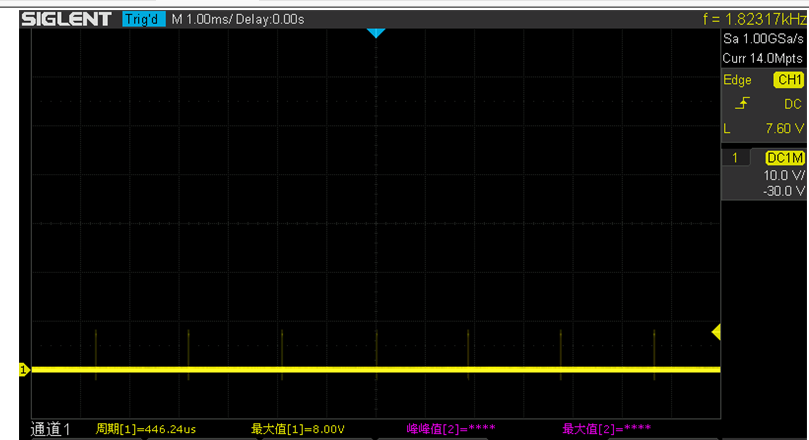
[picture p16: figure]

CH2 SW

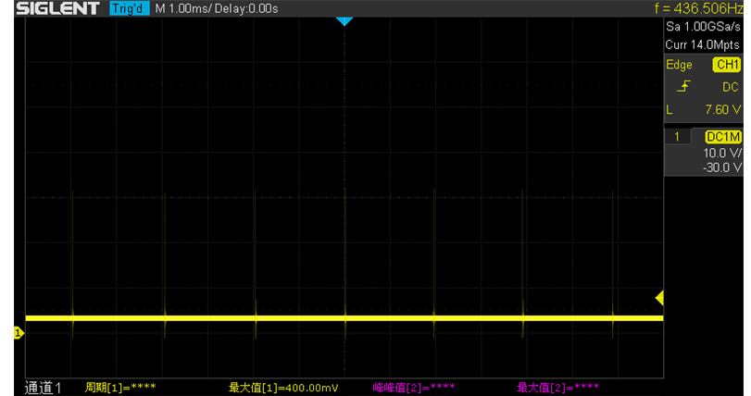
[picture p17: figure]

CH2 GATE H

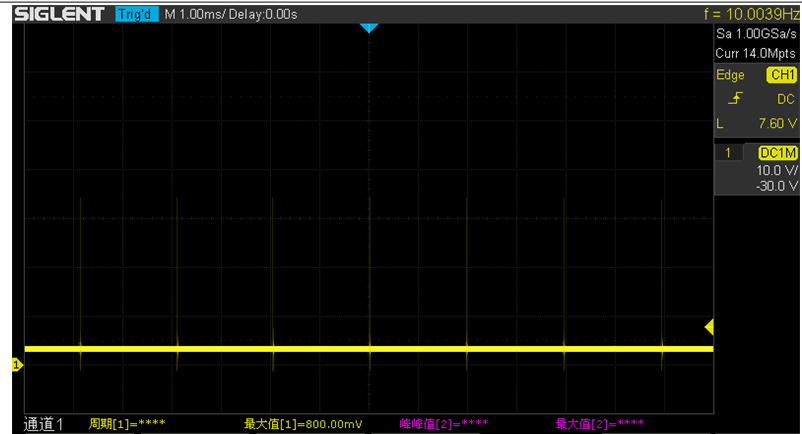
[picture p18: figure]

CH2 GATE L

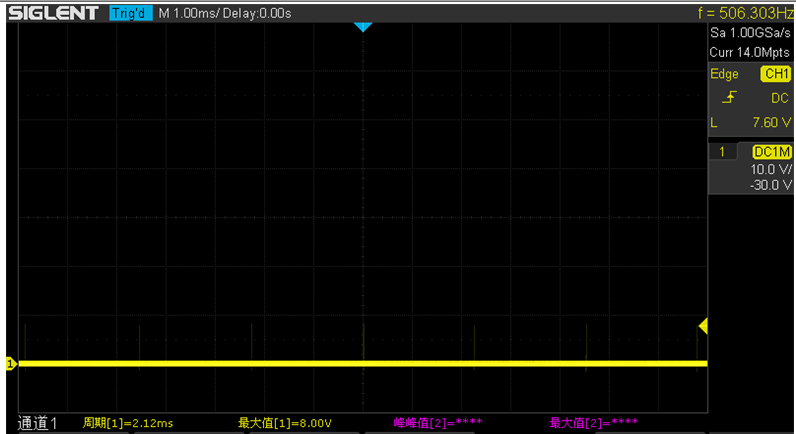
[picture p19: figure]
