briansune/LM25119_30A_EVB/DEBUG/LM25119_DEBUG4.docx

CH1 SW @ NO LOAD

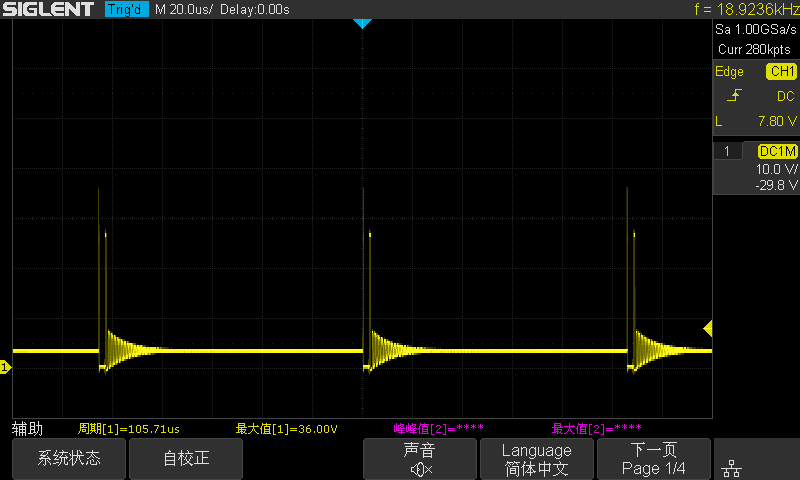
[picture p20: figure]

CH1 BOT GATE @ NO LOAD

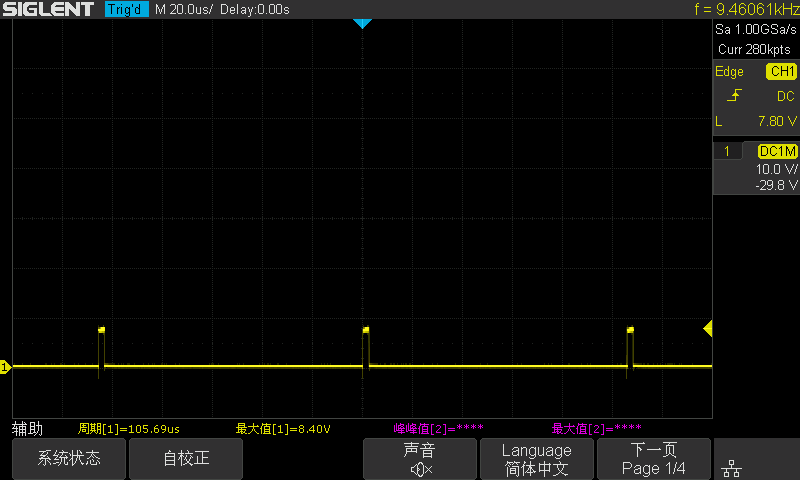
[picture p21: figure]

CH 1 TOP GATE @ NO LOAD

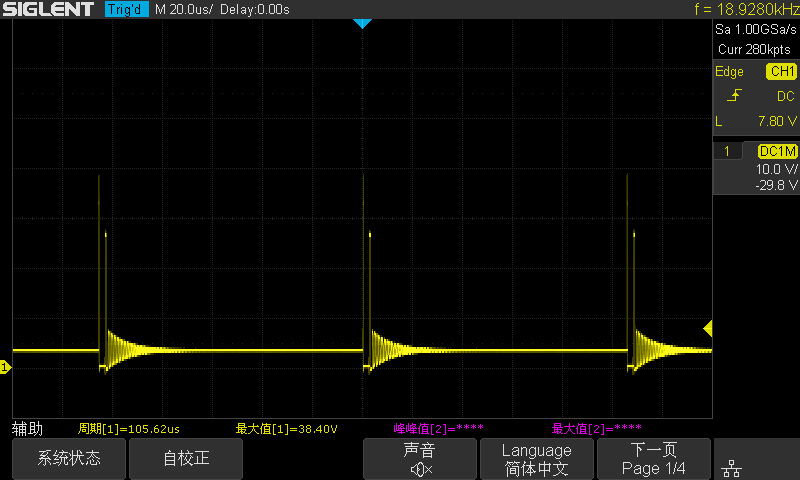
[picture p22: figure]

CH2 SW @ NO LOAD

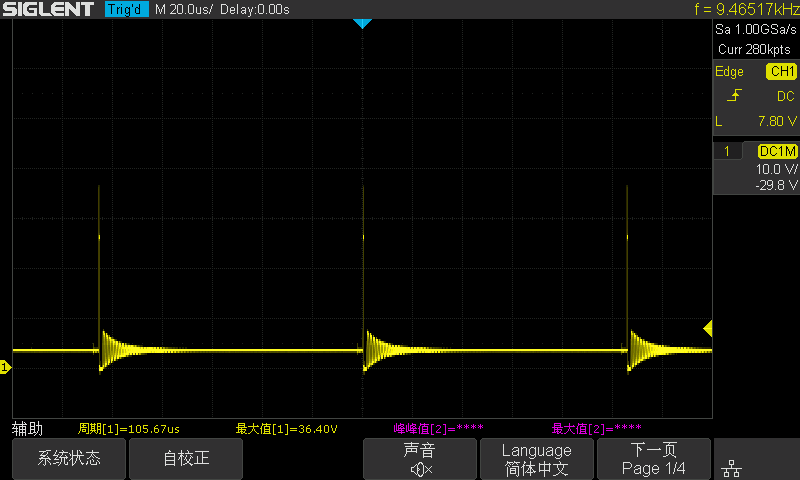
[picture p23: figure]

CH2 BOT GATE @ NO LOAD

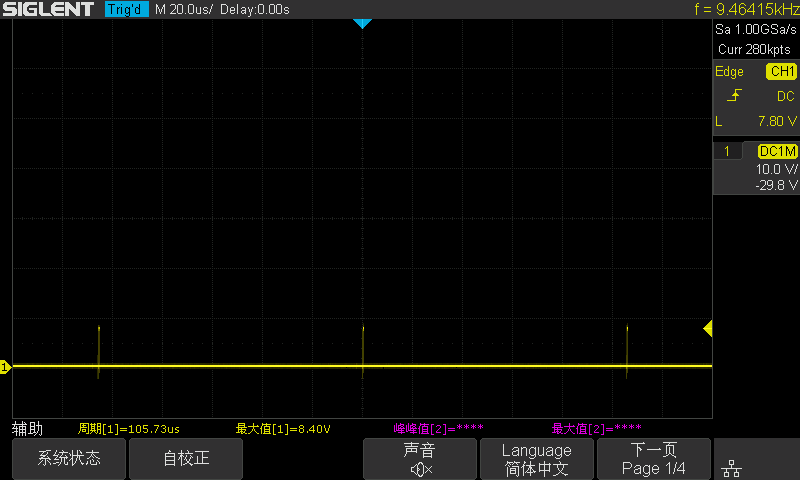
[picture p24: figure]

CH2 TOP GATE @ NO LOAD

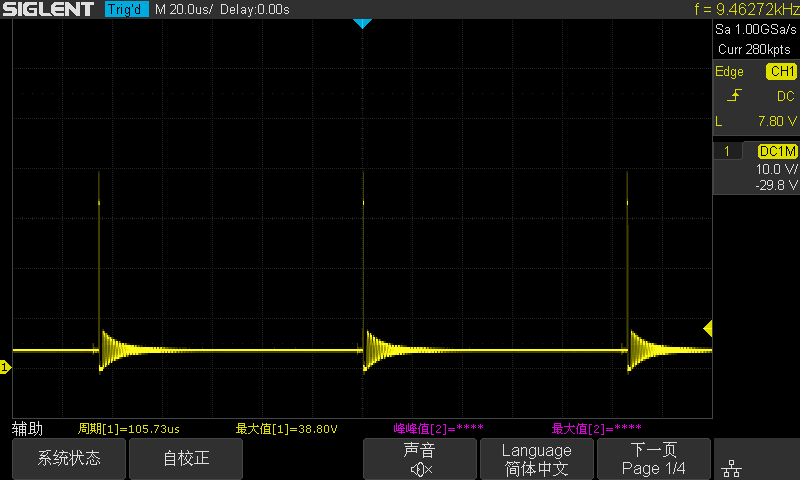
[picture p25: figure]

CH1 SW @ 1A CC

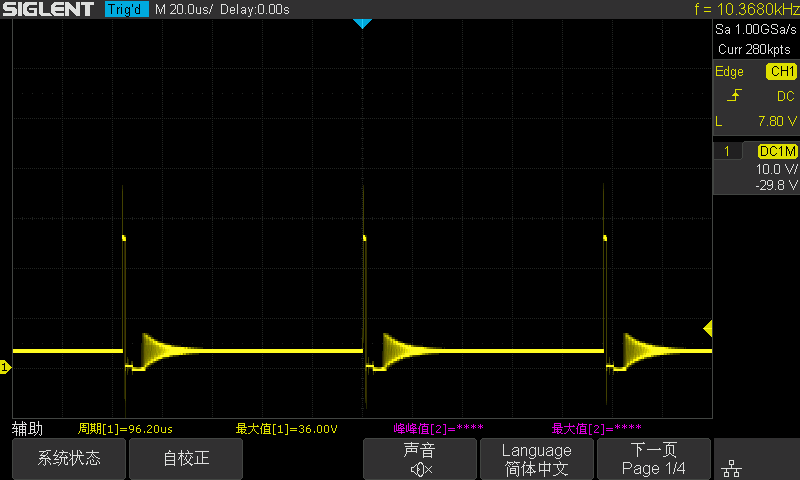
[picture p26: figure]

CH1 BOT GATE @ 1A CC

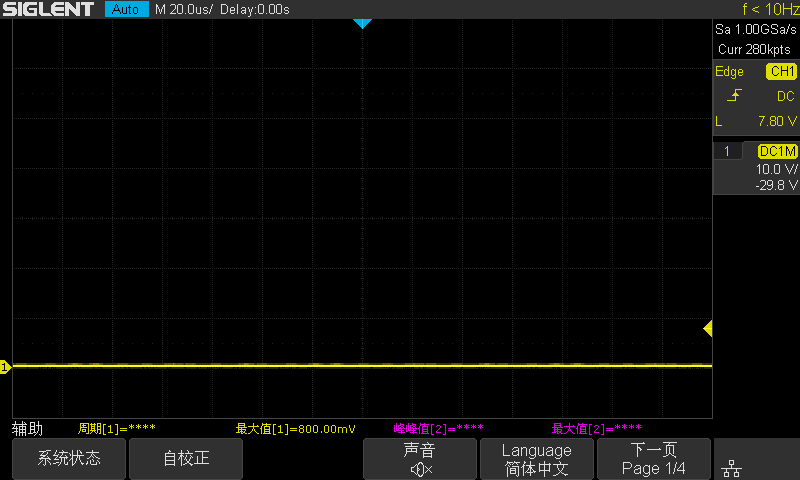
[picture p27: figure]

CH1 TOP GATE @ 1A CC

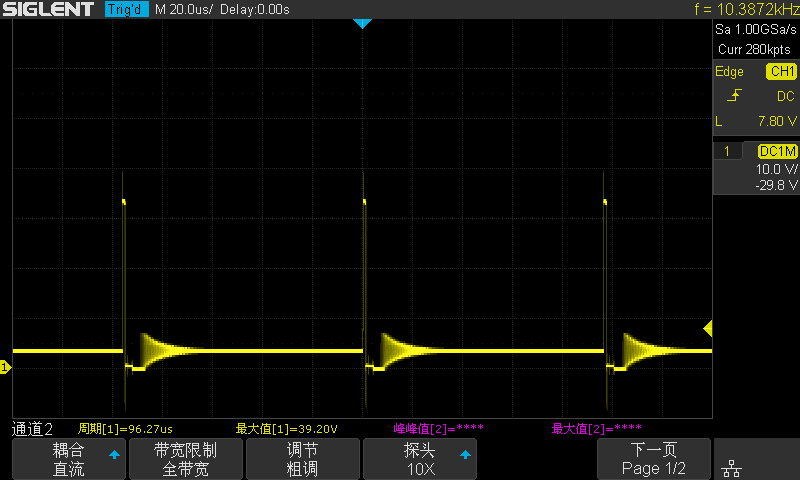
[picture p28: figure]

CH2 SW @ 1A CC

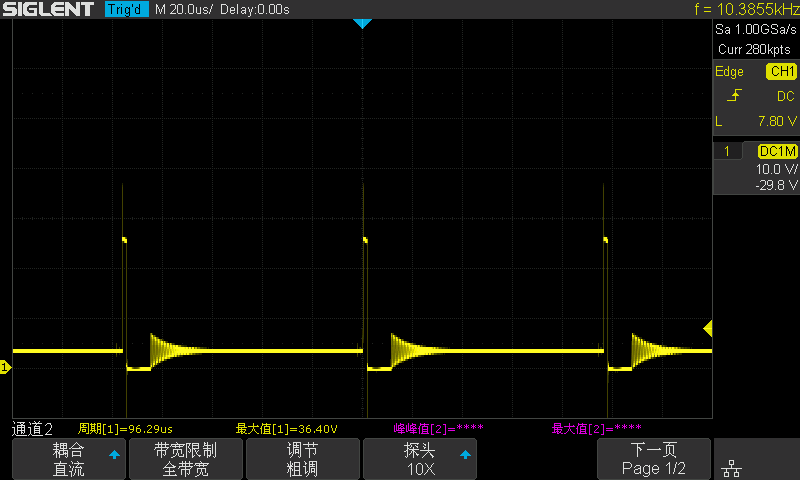
[picture p29: figure]

CH2 BOT GATE @ 1A CC

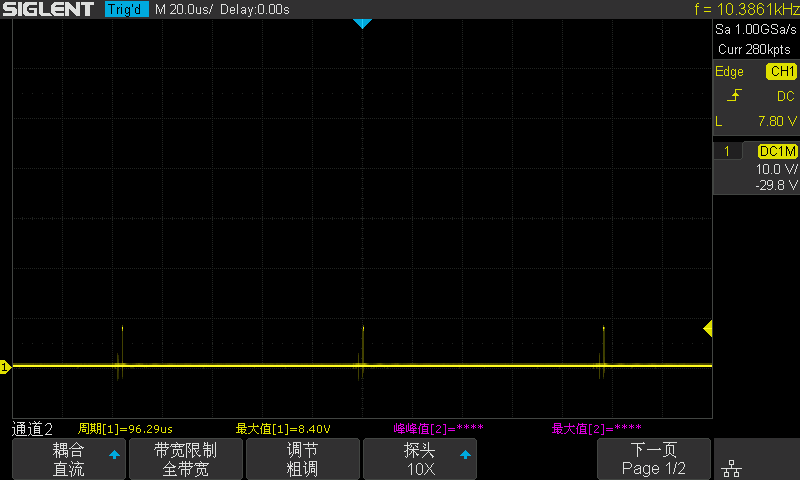
[picture p30: figure]

CH2 TOP GATE @ 1A CC

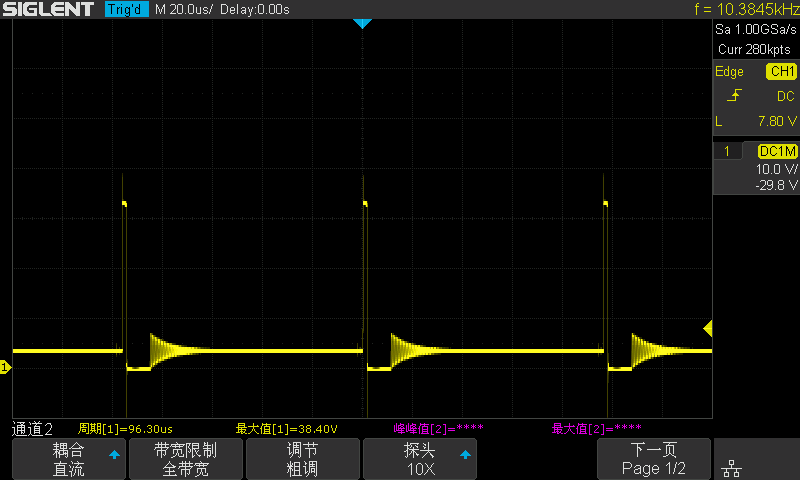
[picture p31: figure]
