briansune/LM25119_30A_EVB/LM25119 1CH Sch V001_reviewed.pdf

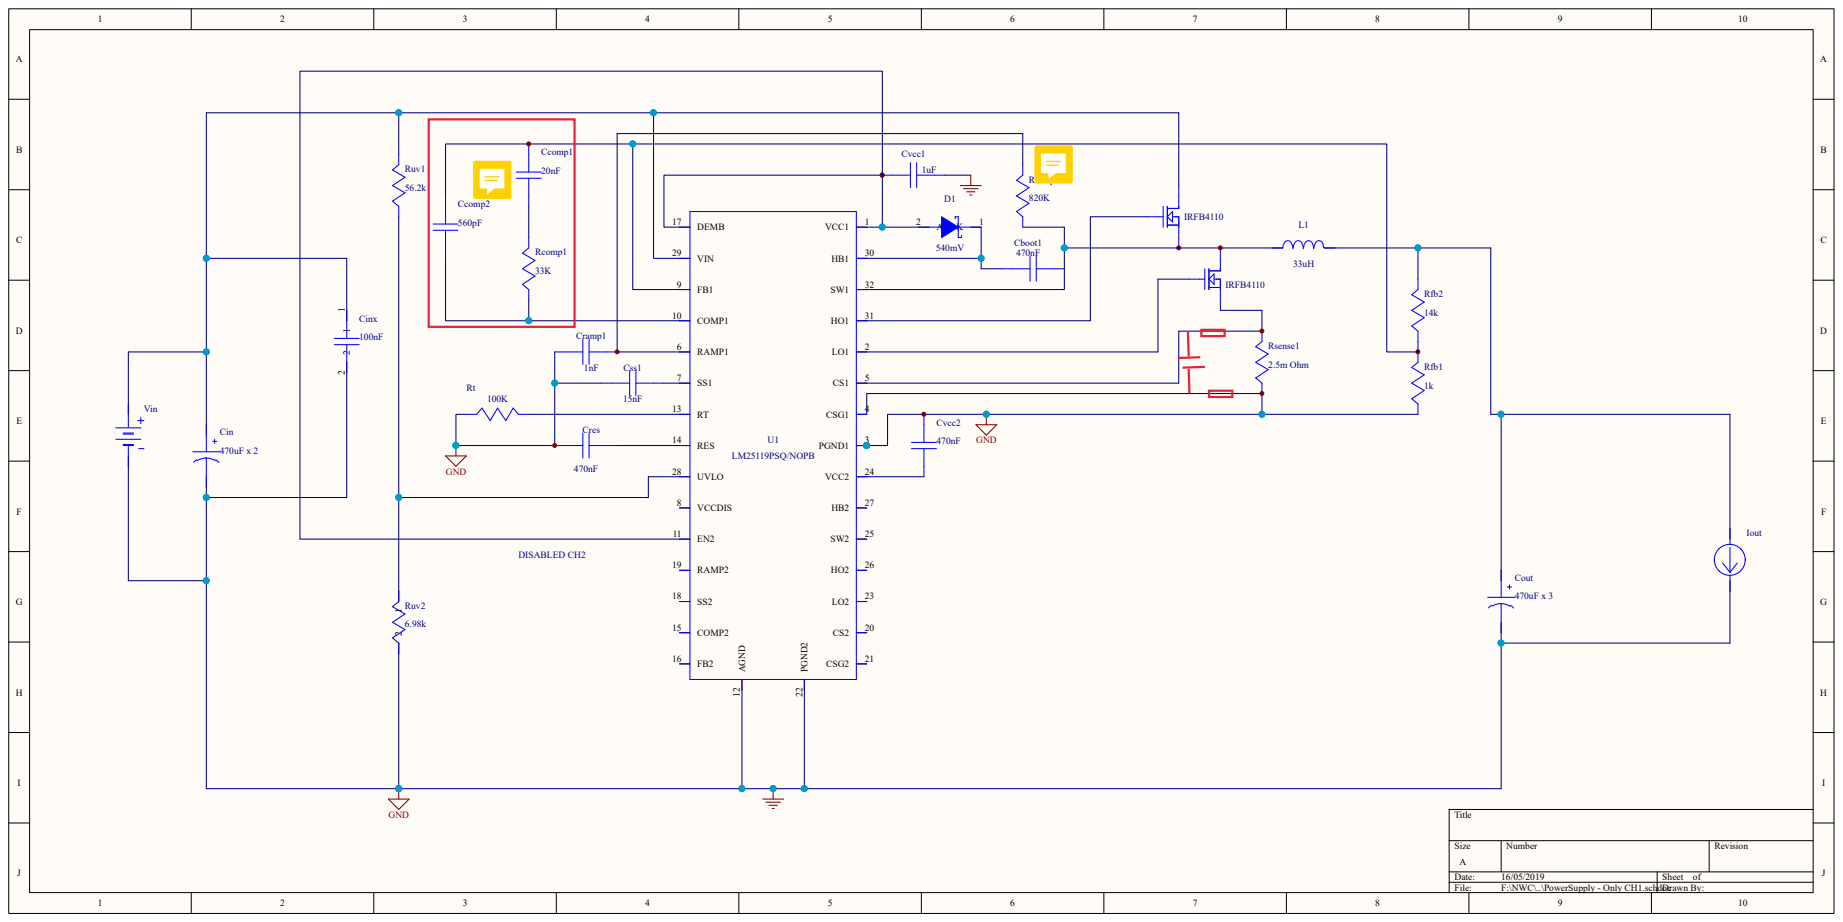
[picture p32: page 1]
Title; Size; Number; Revision; Date:; Sheet of; File:; F:\NWC\..\PowerSupply - Only CH1.schdocDrawn By:; IRFB4110; Rcomp1; Rfb1; Rramp1; Ruv1; VCC1; PGND1; CSG1; RAMP1 6; VCCDIS 8; COMP1 10; AGND 12; RES 14; COMP2 15; DEMB 17; RAMP2 19; CSG2; 21 PGND² 22; VCC2; UVLO 28; VIN 29; LM25119PSQ/NOPB; Ccomp2 1; Cinx; Cramp1; Cvcc1; Rfb2; Ruv2; Cvcc2; 2.5m Ohm; Rsense1; Cboot1; Ccomp1; Cin; Cout; Cres; Css1; Iout; Vin; GND; DISABLED CH2
