briansune/LM25119_30A_EVB/LM25119_EVB_SCH.pdf

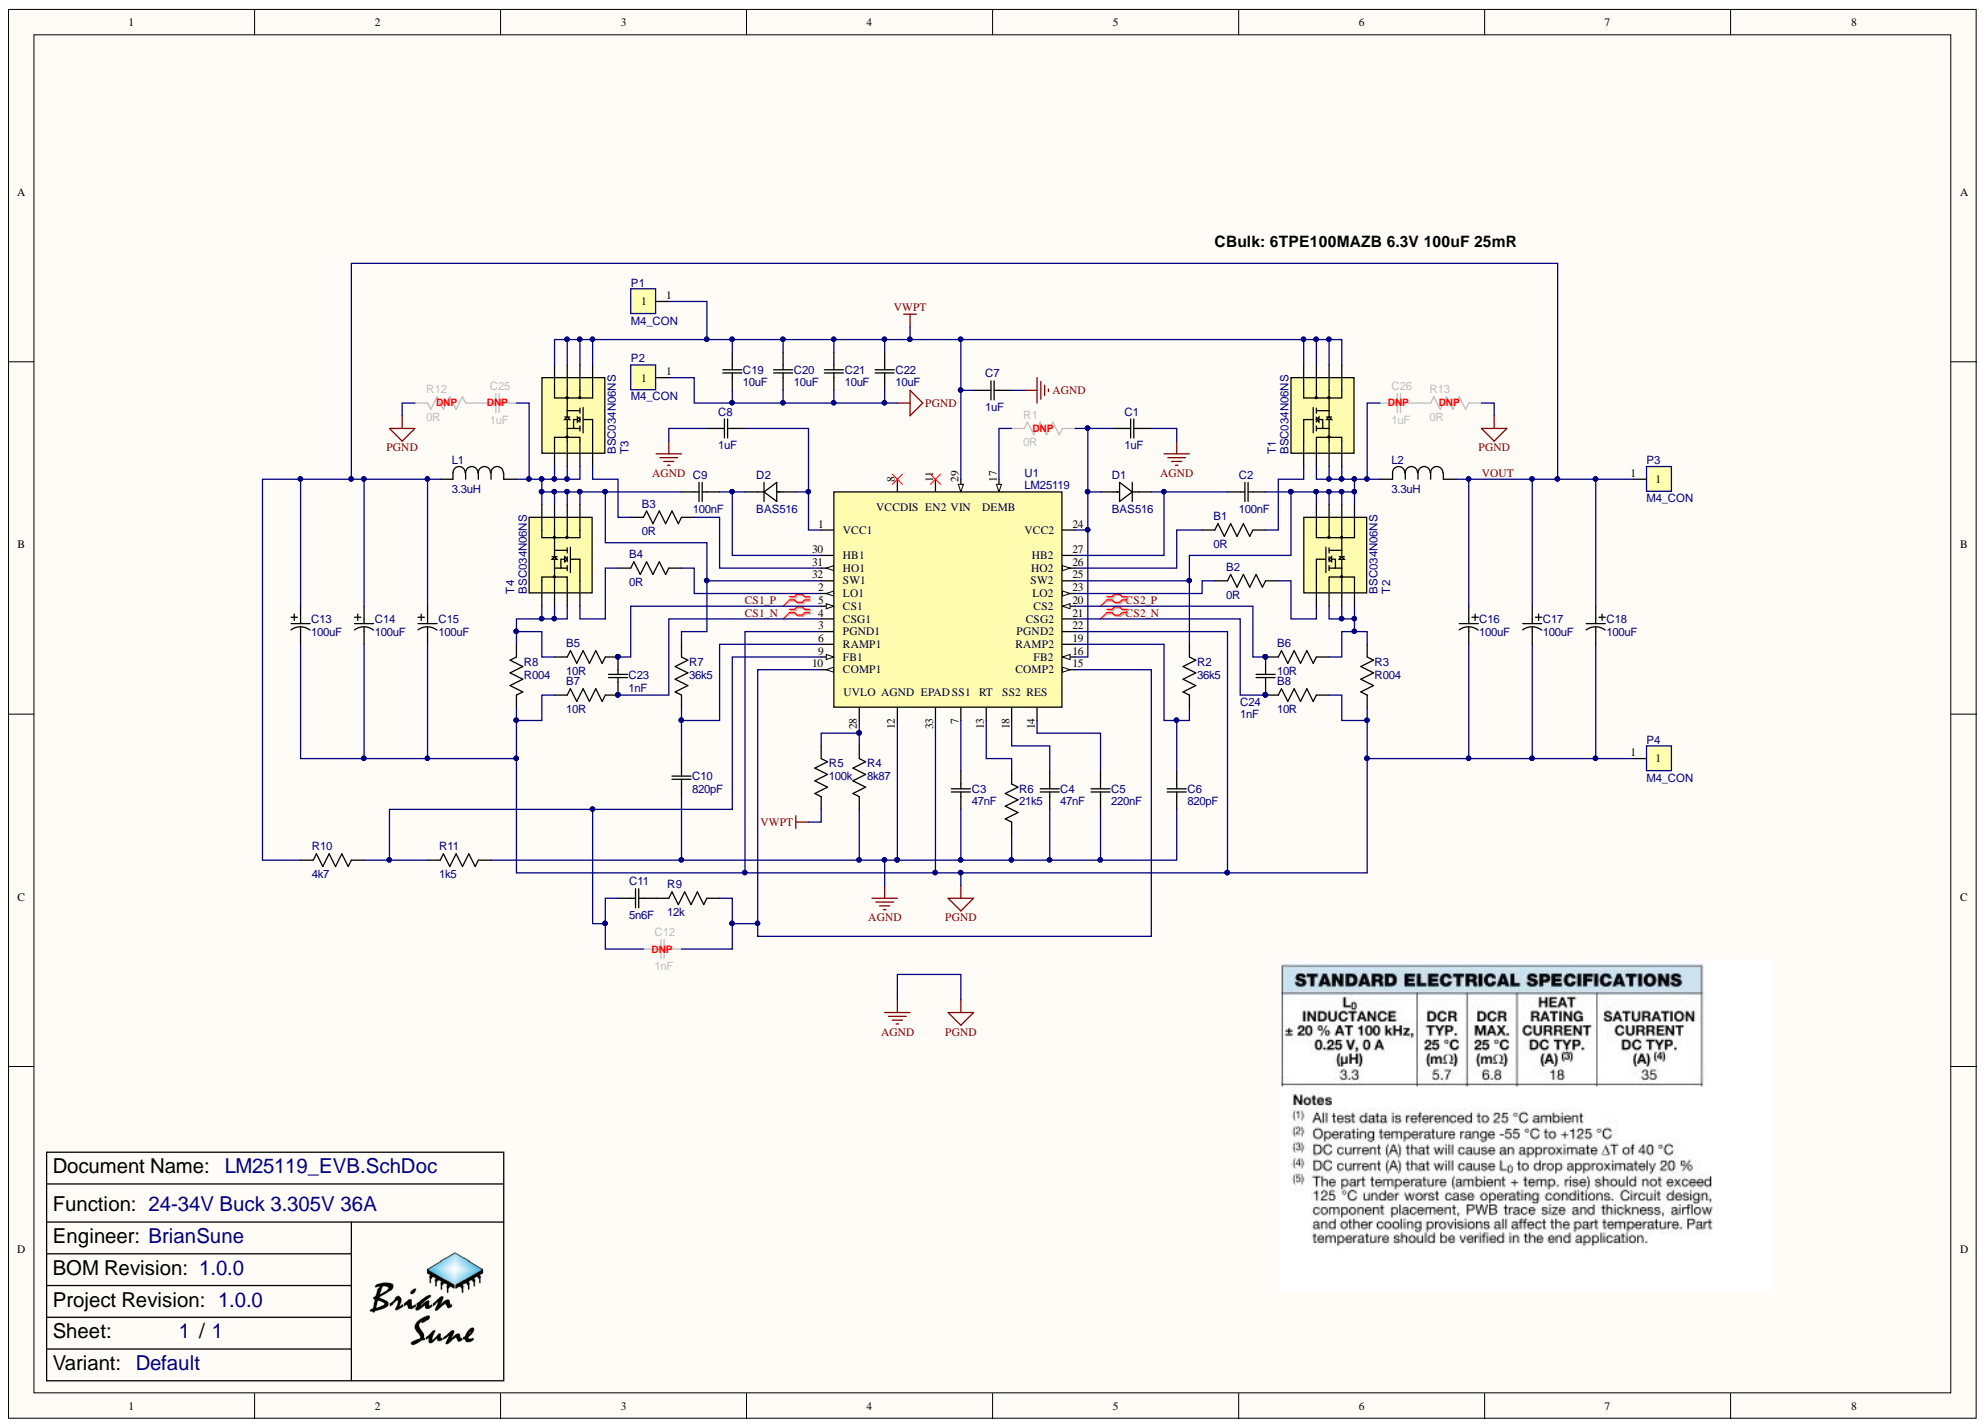
[picture p33: page 1]
