briansune/LM25119_30A_EVB/(list of files, drawings)

Other design files:
LM25119_EVB.PrjPCB
LM25119_EVB.SchDoc
